ALICHOUCHENE/Marine-Robot/README.md

# Marine-Robot

## Thrusters Controller :

### Description :

This intelligent Actuator is designed to controll the two thrusters of the robot.
the board will communicate with the on board computer of the robot via the CAN bus.

**the features of the board are :** 

- STM32F103C8T6 ARM 32-bit Cortex™-M3 is the CPU of the board. Higher frequency, higher speed and cost-effictive.

- 2 channels high power H-bridge .

- SN65HVD230 CAN bus controller Operating with a single 3.3 V Supply and Compatible With ISO 11898-2 Standard.

- Serial wire debuger as a programming interface and USART2 as serial communication interface.

- Operating Voltage up to 24V.

- Maximum Motor Current: 10A continuous, 30 A peak.

- linear regulator to produce 3.3V/1A output with reverse voltage protection.

- LEDs for motor output state.

- PWM frequency up to 20 kHz.

**The schematic of the board :**

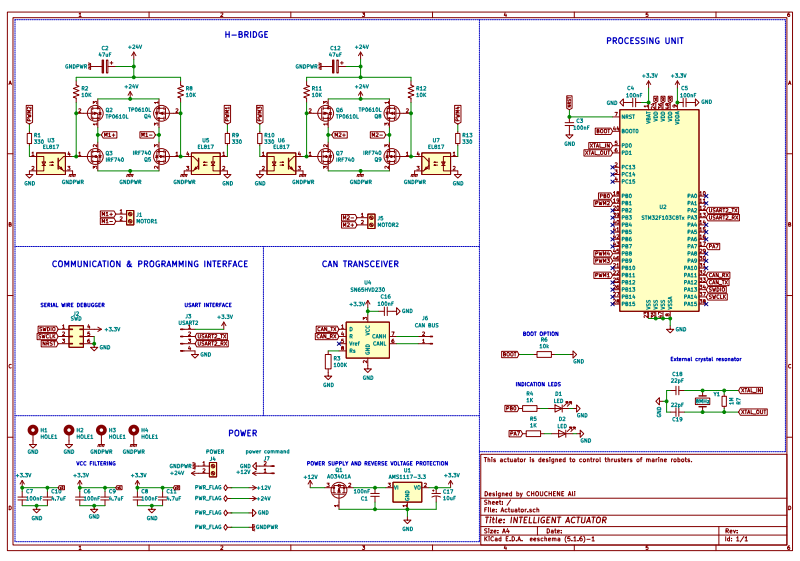
[picture p1: Thrusters Controller/schematic/schematic.PNG]


**The PCB layout of the board :**

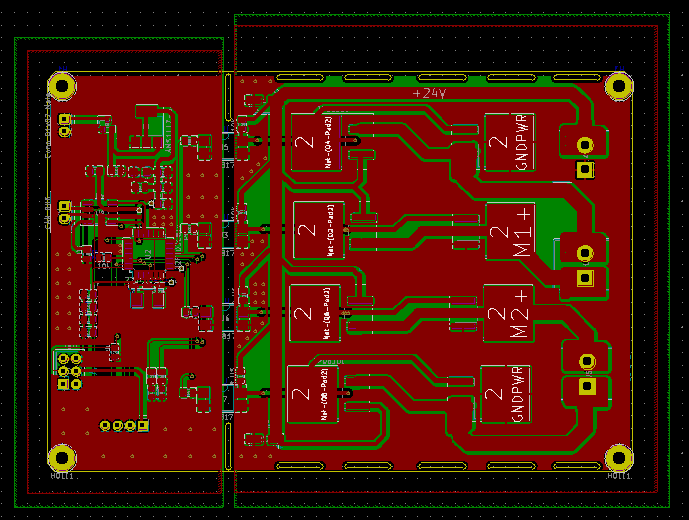
[picture p2: Thrusters Controller/PCB/PCB.PNG]


**Board View :**

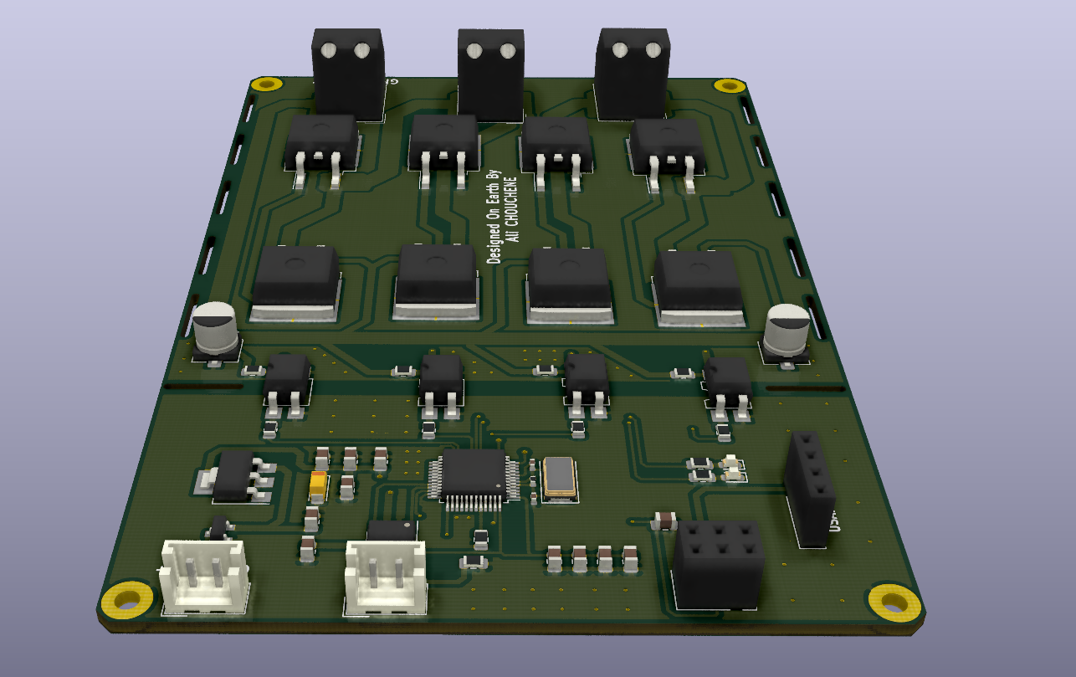
[picture p3: Thrusters Controller/PCB/3D view2.png]


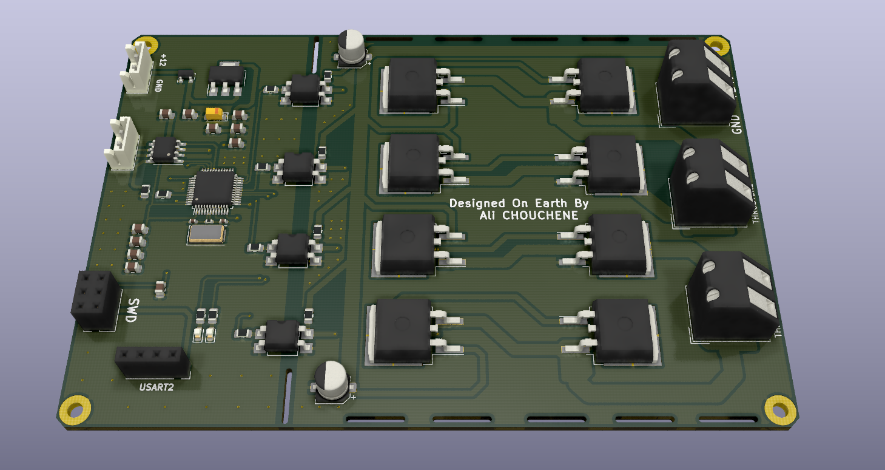
[picture p4: Thrusters Controller/PCB/3D view3.png]


# Manufacturing : 

After finishing the Routing and verifying the pcb. We will make the board at JLC PCB and we chose also the PCB Assembly service.
Here is the BOM and posistion file needed to order from JLC PCB :

**BOM :**

| Designator  | Value | Footprint | LCSC Part |
|---|---|---|---|
| C1  | 100nF | C_0805_2012Metric | C49678 |
| C3  | 100nF | C_0805_2012Metric | C49678 |
| C4  | 100nF | C_0805_2012Metric | C49678 |
| C5  | 100nF | C_0805_2012Metric | C49678 |
| C6  | 100nF | C_0805_2012Metric | C49678 |
| C7  | 100nF | C_0805_2012Metric | C49678 |
| C8  | 100nF | C_0805_2012Metric | C49678 |
| C16 | 100nF | C_0805_2012Metric | C49678 |
| C9  | 4.7uF | C_0805_2012Metric | C1779 |
| C10 | 4.7uF | C_0805_2012Metric | C1779 |
| C11 | 4.7uF | C_0805_2012Metric | C1779 |
| C2  | 47uF | Capacitor_SMD:CP_Elec_5x5.3 | C134798 |
| C12 | 47uF | Capacitor_SMD:CP_Elec_5x5.3 | C134798 |
| C17 | 10UF | Capacitor_Tantalum_SMD:CP_EIA-3216-18_Kemet-A | C7171 |
| C18 | 22pF | C_0402_0603Metric | C70464 |
| C19 | 22pF | C_0402_0603Metric | C70464 |
| D1  | LED | LED_0603_1608Metric | C916074 |
| D2  | LED | LED_0603_1608Metric | C916074 |
| J1  | MOTOR1 | TerminalBlock_Altech:Altech_AK300_1x02_P5.00mm_45-Degree | C430582 |
| J4  | MOTOR2 | TerminalBlock_Altech:Altech_AK300_1x02_P5.00mm_45-Degree | C430582 |
| J5  | POWER | TerminalBlock_Altech:Altech_AK300_1x02_P5.00mm_45-Degree | C430582 |
| Q1  | AO3401A | Package_TO_SOT_SMD:SOT-23 | C15127 |
| Q2  | TP0610L | Package_TO_SOT_SMD:TO-263-2 | C468007 |
| Q4  | TP0610L | Package_TO_SOT_SMD:TO-263-2 | C468007 |
| Q6  | TP0610L | Package_TO_SOT_SMD:TO-263-2 | C468007 |
| Q8  | TP0610L | Package_TO_SOT_SMD:TO-263-2 | C468007 |
| Q3  | IRF740 | Package_TO_SOT_SMD:TO-263-2 | C483709 |
| Q5  | IRF740 | Package_TO_SOT_SMD:TO-263-2 | C483709 |
| Q7  | IRF740 | Package_TO_SOT_SMD:TO-263-2 | C483709 |
| Q9  | IRF740 | Package_TO_SOT_SMD:TO-263-2 | C483709 |
| R1  | 330 | R_0805_2012Metric | C17630 |
| R9  | 330 | R_0805_2012Metric | C17630 |
| R10 | 330 | R_0805_2012Metric | C17630 |
| R13 | 330 | R_0805_2012Metric | C17630 |
| R3  | 100K | R_0805_2012Metric | C17407 |
| R4  | 1K | R_0805_2012Metric | C17513 |
| R5  | 1K | R_0805_2012Metric | C17513 |
| R6  | 10k | R_0805_2012Metric | C17733 |
| R7  | 1M | R_0402_2012Metric | C26083 |
| R2  | 10K | R_0805_2012Metric | C17733 |
| R8  | 10K | R_0805_2012Metric | C17733 |
| R11 | R_US | R_0805_2012Metric | C17733 |
| R12 | R_US | R_0805_2012Metric | C17733 |
| U1  | AMS1117-3.3 | Package_TO_SOT_SMD:SOT-223-3_TabPin2 | C6186 |
| U2  | STM32F103C8Tx | Package_QFP:LQFP-48_7x7mm_P0.5mm | C8734 |
| U3  | EL817 | Package_DIP:SMDIP-4_W7.62mm | C106900 |
| U5  | EL817 | Package_DIP:SMDIP-4_W7.62mm | C106900 |
| U6  | EL817 | Package_DIP:SMDIP-4_W7.62mm | C106900 |
| U7  | EL817 | Package_DIP:SMDIP-4_W7.62mm | C106900 |
| U4  | SN65HVD230 | Package_SO:SOIC-8_3.9x4.9mm_P1.27mm | C12084 |
| Y1  | 8MHz | Crystal:Crystal_SMD_0603-2Pin_6.0x3.5mm | C128364 |

**Position file :**

| Designator | Value | Footprint | Mid X | Mid Y | Rotation | Layer |
|---|---|---|---|---|---|---|
| C1 | 100nF | C_0805_2012Metric | 89.154  | -95.504  | 0 | top |
| C2 | 47uF | CP_Elec_5x5.3 | 119.126 | -149.606 | 180 | top |
| C3 | 100nF | C_0805_2012Metric | 88.9 | -132.08  | 270 | top |
| C4 | 100nF | C_0805_2012Metric | 98.552  | -98.806  | 0 | top |
| C5 | 100nF | C_0805_2012Metric | 83.566  | -128.016 | 0 | top |
| C6 | 100nF | C_0805_2012Metric | 98.552  | -102.108 | 0 | top |
| C7 | 100nF | C_0805_2012Metric | 84.836  | -95.504  | 180 | top |
| C8 | 100nF | C_0805_2012Metric | 83.566  | -120.396 | 180 | top |
| C9 | 4.7uF | C_0805_2012Metric | 83.566  | -122.936 | 180 | top |
| C10 | 4.7uF | C_0805_2012Metric | 98.552  | -95.758  | 0 | top |
| C11 | 4.7uF | C_0805_2012Metric | 93.98 | -98.806  | 180 | top |
| C12 | 47uF | CP_Elec_5x5.3 | 119.126 | -81.28 | 180 | top |
| C16 | 100nF | C_0805_2012Metric | 83.566  | -125.476 | 180 | top |
| C17 | 10uF | CP_EIA-3216-18_Kemet-A | 93.98 | -95.758  | 180 | top |
| C18 | 22pF | C_0402_1005Metric | 92.687  | -118.618 | 180 | top |
| C19 | 22pF | C_0402_1005Metric | 98.044  | -118.618 | 0 | top |
| D1 | LED | LED_0603_1608Metric | 98.298  | -140.208 | 90 | top |
| D2 | LED | LED_0603_1608Metric | 96.266  | -140.208 | 90 | top |
| Q1 | AO3401A | SOT-23 | 87.376  | -86.106  | 90 | top |
| Q2 | TP0610L | TO-263-2 | 133.35  | -107.442 | 180 | top |
| Q3 | IRF740 | TO-263-2 | 165.354 | -107.696 | 0 | top |
| Q4 | TP0610L | TO-263-2 | 132.842 | -89.662  | 180 | top |
| Q5 | IRF740 | TO-263-2 | 165.166 | -89.662  | 0 | top |
| Q6 | TP0610L | TO-263-2 | 132.588 | -124.206 | 180 | top |
| Q7 | IRF740 | TO-263-2 | 164.846 | -124.206 | 0 | top |
| Q8 | TP0610L | TO-263-2 | 132.08  | -140.462 | 180 | top |
| Q9 | IRF740 | TO-263-2 | 164.338 | -140.462 | 0 | top |
| R1 | 330 | R_0805_2012Metric | 103.886 | -107.188 | 0 | top |
| R2 | 10K | R_0805_2012Metric | 114.554 | -103.886 | 270 | top |
| R3 | 100K | R_0805_2012Metric | 83.312  | -112.268 | 270 | top |
| R4 | 1K | R_0805_2012Metric | 98.298  | -136.906 | 90 | top |
| R5 | 1K | R_0805_2012Metric | 96.266  | -136.906 | 90 | top |
| R6 | 10k | R_0805_2012Metric | 86.614  | -113.03  | 0 | top |
| R7 | 1M | R_0402_1005Metric | 95.504  | -118.618 | 0 | top |
| R8 | 10K | R_0805_2012Metric | 114.554 | -86.106  | 270 | top |
| R9 | 330 | R_0805_2012Metric | 103.886 | -89.408  | 0 | top |
| R10 | 330 | R_0805_2012Metric | 104.14  | -123.952 | 0 | top |
| R11 | R_US | R_0805_2012Metric | 114.808 | -120.65  | 270 | top |
| R12 | R_US | R_0805_2012Metric | 114.3 | -136.906 | 270 | top |
| R13 | 330 | R_0805_2012Metric | 103.632 | -140.208 | 0 | top |
| U1 | AMS1117-3.3 | SOT-223-3_TabPin2 | 95.25 | -86.614  | 90 | top |
| U2 | STM32F103C8Tx | LQFP-48_7x7mm_P0.5mm | 95.758  | -112.268 | 90 | top |
| U3 | EL817 | SMDIP-4_W7.62mm | 110.744 | -108.458 | 0 | top |
| U4 | SN65HVD230 | SOIC-8_3.9x4.9mm_P1.27mm | 85.852  | -103.886 | 180 | top |
| U5 | EL817 | SMDIP-4_W7.62mm | 110.744 | -90.678  | 0 | top |
| U6 | EL817 | SMDIP-4_W7.62mm | 110.998 | -125.222 | 0 | top |
| U7 | EL817 | SMDIP-4_W7.62mm | 110.49  | -141.478 | 0 | top |
| Y1 | 8MHz | Crystal_SMD_0603-2Pin_6.0x3.5mm | 95.504  | -121.412 | 0 | top |

**JLC PCB Ordering :**
After uploading the Gerber file, the BOM and the position file JLC website will generate the 3D view of the board:

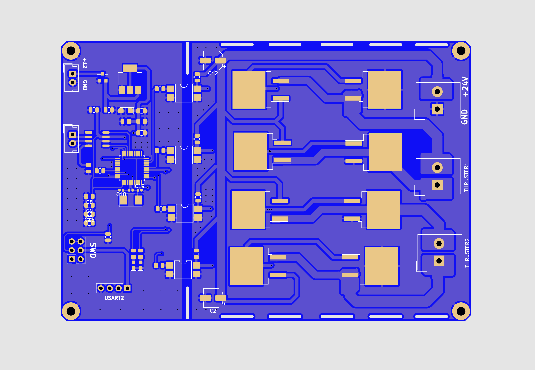
[picture p5: Thrusters Controller/Assembly/JLC PCB.PNG]


# Downloads

* [Board schematics](https://github.com/ALICHOUCHENE/Marine-Robot/blob/main/Thrusters%20Controller/schematic/Actuator.pdf)

* [BOM](https://github.com/ALICHOUCHENE/Marine-Robot/blob/main/Thrusters%20Controller/Assembly/BOM.xlsx)

* [Position file](https://github.com/ALICHOUCHENE/Marine-Robot/blob/main/Thrusters%20Controller/Assembly/Actuator-all-pos.xlsx)

* [Gerber File](https://github.com/ALICHOUCHENE/Marine-Robot/blob/main/Thrusters%20Controller/Gerber%20file/GERBER.rar)
