ALICHOUCHENE/Marine-Robot/Thrusters Controller/PCB/3D view1.png

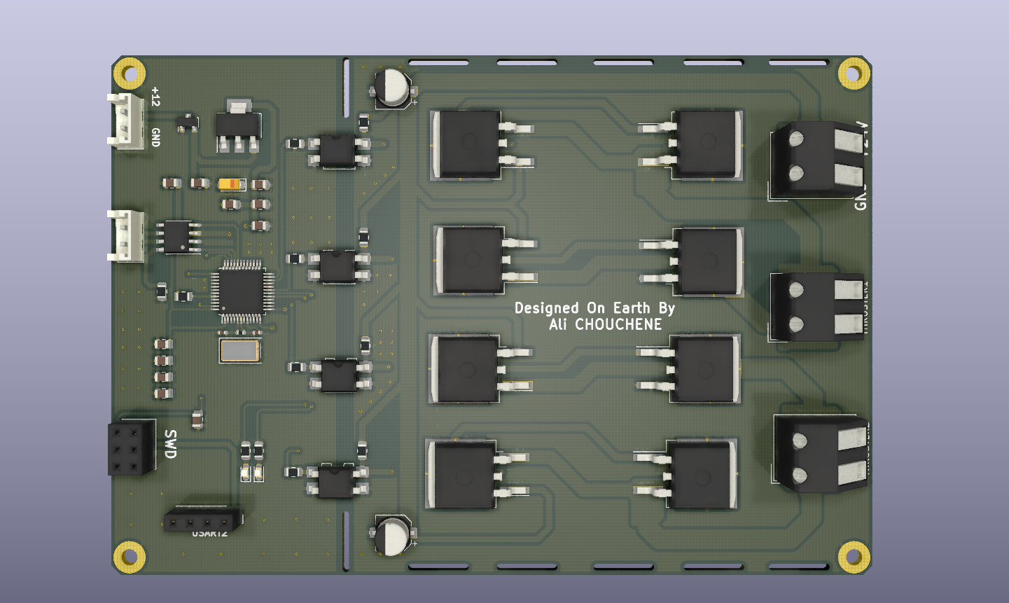
Thrusters Controller/PCB/3D view1.png
