ALICHOUCHENE/Marine-Robot/Thrusters Controller/schematic/Actuator.pdf

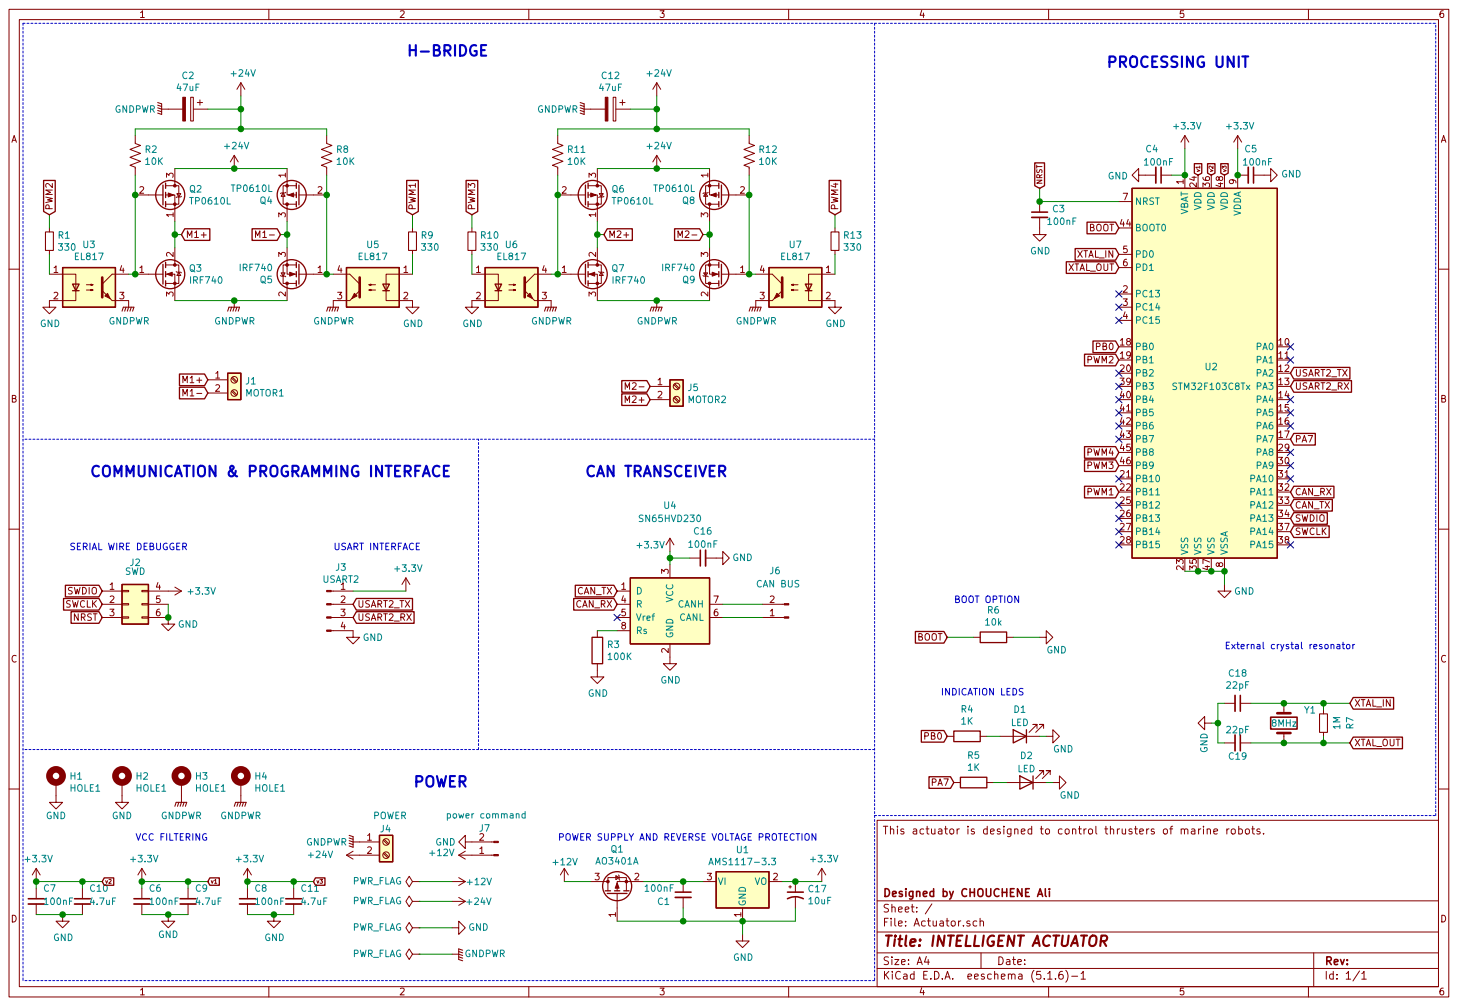
[picture p7: page 1]

1 VDD 24 VDD 36 VDD 48 VDDA

9 VSS 23 VSS 35 VSS 47 VSSA

This actuator is designed to control thrusters of marine robots. +3.3V GNDPWR
J1MOTOR1 C8

External crystal resonator BOOT OPTION

POWER SUPPLY AND REVERSE VOLTAGE PROTECTION

File: Actuator.sch Sheet: / Designed by CHOUCHENE Ali

Id: 1/1 Title: INTELLIGENT ACTUATOR
