ALICHOUCHENE/Marine-Robot/Code/SRC/main.c

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
/* Includes ------------------------------------------------------------------*/
#include "main.h"


uint16_t RX_msg=0x0000;

// Own and remote ID

uint16_t own_ID=0xAAA;
uint16_t remote_ID=0xBBB;


CAN_HandleTypeDef hcan;

TIM_HandleTypeDef htim2;
TIM_HandleTypeDef htim3;
TIM_HandleTypeDef htim4;

void SystemClock_Config(void);
static void MX_GPIO_Init(void);
static void MX_CAN_Init(void);
static void MX_TIM2_Init(void);
static void MX_TIM3_Init(void);
static void MX_TIM4_Init(void);
/* USER CODE BEGIN 0 */
/* for all timers we have set:
the PSR to 0+1
the ARR to 3600-1
in order to get a PWM signal with 20 kHz frequency ( recommanded in the datasheet of the thruster ).
for MOTOR1 we assigned:
  	  	  	  	  	  	  *TIM3_CH4
  	  	  	  	  	  	  *TIM2_CH4
for MOTOR2 we assigned:
  	  	  	  	  	  	  *TIM4_CH4
  	  	  	  	  	  	  *TIM4_CH3

*/
// thruster 1 :
void thruster1_forward(int v) //pass the the speed command (0%-->100%)
{
	uint16_t x=0x00;
	if(v>=0 && v<=100)
	{x=((3600-1)*v)/100;
		htim3.Instance->CCR4=x;
		htim2.Instance->CCR4=0;
	}
}

void thruster1_backward(int v) //pass the the speed command (0%-->100%)
{
	uint16_t x=0x00;
	if(v>=0 && v<=100)
	{x=((3600-1)*v)/100;
		htim3.Instance->CCR4=0;
		htim2.Instance->CCR4=x;
	}
}



// thruster 2 :
void thruster2_forward(int v) //pass the the speed command (0%-->100%)
{
	uint16_t x=0x00;
	if(v>=0 && v<=100)
	{x=((3600-1)*v)/100;
		htim4.Instance->CCR3=x;
		htim4.Instance->CCR4=0;
	}
}

void thruster2_backward(int v) //pass the the speed command (0%-->100%)
{
	uint16_t x=0x00;
	if(v>=0 && v<=100)
	{x=((3600-1)*v)/100;
		htim4.Instance->CCR3=0;
		htim4.Instance->CCR4=x;
	}
}









/* USER CODE END 0 */

/**
  * @brief  The application entry point.
  * @retval int
  */
int main(void)
{
  /* MCU Configuration--------------------------------------------------------*/

  /* Reset of all peripherals, Initializes the Flash interface and the Systick. */
  HAL_Init();

  /* Configure the system clock */
  SystemClock_Config();

  /* Initialize all configured peripherals */
  MX_GPIO_Init();
  MX_CAN_Init();
  MX_TIM2_Init();
  MX_TIM3_Init();
  MX_TIM4_Init();
  /* USER CODE BEGIN 2 */
  //start listening to Can with RX interrupt
 // HAL_CAN_Receive_IT(&hcan1, CAN_FIFO0);






  /* USER CODE END 2 */
// start all timers :
  HAL_TIM_PWM_Start(&htim3, TIM_CHANNEL_4);
  HAL_TIM_PWM_Start(&htim2, TIM_CHANNEL_4);
  HAL_TIM_PWM_Start(&htim4, TIM_CHANNEL_4);
  HAL_TIM_PWM_Start(&htim4, TIM_CHANNEL_3);
  HAL_CAN_ConfigFilter(&hcan, sFilterConfig);
  HAL_CAN_ActivateNotification(&hcan, CAN_IT_RX_FIFO0_MSG_PENDING);


  HAL_CAN_Start(&hcan);

  /* Infinite loop */
  /* USER CODE BEGIN WHILE */
  while (1)
  {
    /* USER CODE END WHILE */

    /* USER CODE BEGIN 3 */
  }
  /* USER CODE END 3 */
}

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
